tsonubin/ps5-slim-stand/docs/CONTINUE.md

# Continue the PS5 Slim dock

## Latest request
Continue the existing Claude PS5 Slim vertical-stand design in a new project using Astra.

The exact final user message in Claude was:

> I think you are too truthful to my drawings, but you nailed the vibe.  The only think I want you to optimize is that I want to have better curve, more continuous, natural curve. And please optimize for 3D printing. The bottom is not very pretty, also please take consideration of it, and also the aerodynamic of the bottom intake of PS5 slim (Actually I'm not sure if it is intake or outtake)

Claude stopped without answering because its usage credits were exhausted. Do not restart Claude or purchase credits.

## Design intent and evolution
The user wants to elevate a vertical PS5 Slim, preserve its sleek curves, improve ventilation, and resist tipping. Blue or white printing was explicitly requested. The most recent model is for the **Disc** version, as indicated by the sketch and Claude's response.

Earlier bulky spider-web and flat truss versions were rejected. The user wanted cool bridge architecture, minimal triangular structure, physics checks, more curves, body-following supports, asymmetry and compactness. The user supplied the Sketchfab reference and later the actual model archive, which revealed earlier straight-sided fit assumptions were wrong. Do not revive v3 or treat its dimensions/simulation figures as reliable.

The preferred latest direction is one piece with a flowing exterior, hidden structural complexity, a sculptural saddle rim and lattice skin inspired by Zaha Hadid. The user said “Bella Hadid's architecture”; Claude interpreted this as Zaha Hadid, and the subsequent feedback accepted the vibe. The sketch is guidance, not a literal shape to reproduce.

A looser fit was explicitly requested. v4/v5 used 1.5 mm clearance all around. Retain appropriate tolerance and provide a low-cost fit gauge before the full print. The fan-made reference is not a verified scan of the user's actual hardware.

## Latest v5, as reported by Claude (not independently verified)
- One body, smooth inner wall, diamond lattice outer skin, zig-zag buttress ribs between them.
- Under-console triangulated rib web with pointed arches and diamond windows.
- Footprint 154 × 244 mm, maximum height 72 mm, approximately 200 g PLA.
- Saddle rim: 46 mm middle, 72 mm rear corners, 60 mm front corners, 38–40 mm front/back walls.
- Lattice 68 × 3 cells; 2 mm struts; generated in 0.5 mm steps, producing visible terracing.
- Claude claimed 46° or steeper opening roofs and 47° minimum strut slope, upright printing without support. **It was never sliced or printed.**
- Claimed tipping force 6.0–6.9 N and rough strength margin 5–12×. These were simplified estimates; no lattice stress simulation was run.
- Rear wall reportedly 10 mm above the console base, rear power socket clearance unverified.
- Front rim reportedly up to 20 mm above console base; disc-slot start guessed at 26 mm from a screenshot.
- Console load should be supported on the black core, not suspended from white covers.

## Inputs already present
- `references/PS5_Slim-a48efc06.zip`: user-supplied archive already in Downloads, copied without alteration.
- `references/console-model/PS5_Slim.glb` and accompanying glTF/bin files: extracted from the same archive.
- `references/IMG_6973.HEIC`: original sketch already in Downloads, copied without alteration.
- `docs/claude-conversation.md`: recovered visible conversation text. The first prompt is visibly truncated, and table formatting is flattened. Treat earlier assistant claims as historical evidence, not verified design facts.
- Model source: https://sketchfab.com/3d-models/ps5-slim-a48efc06663541a1bc19297995fea91d, author rtql8d.
- Chat: https://claude.ai/chat/f4d270b2-2594-4b75-a828-277e58a32ab0

## v5 source import completed
The user supplied all four files directly. Originals are preserved in `references/user-imports/`; their Library identities, versions and SHA-256 hashes are recorded in `docs/import-manifest.json`.

The complete source ZIP is extracted at `designs/imported/ps5_veil_stand_v5/`:
- `source/ps5_veil_stand.py` (main generator)
- `source/checks.py`, `source/splat.py`, `source/preview.py`, `source/outline.json`
- `ps5_slim_disc_veil_stand.3mf` and `ps5_slim_disc_veil_stand.stl`
- `GAUGE_cavity_outline_1.6mm.stl`, `preview.png`, `checks.txt`

ZIP integrity passed. The separately uploaded 3MF is byte-identical to the one in the ZIP. The uploaded console ZIP matches the earlier local copy. The separately uploaded preview is different bytes from the ZIP's preview; keep both, and use `references/user-imports/preview.png` as the explicit uploaded visual reference. It has been visually inspected and shows the flowing saddle, flared diamond-lattice shell and angular radial bottom web in white and blue.

The earlier browser download is no longer needed. Do not retry it or any denied Codex UI operation.

Source was read but **not executed**. It uses numpy, manifold3d, scipy, trimesh and Pillow. The generator writes an `out/` directory including V.npy, F.npy, footprint.npy and console_ghost.stl; these intermediate files are not in the ZIP and must be regenerated for preview/check scripts. `preview.py` has a Linux DejaVu font path that will need a portable replacement on macOS. Preserve imported originals and work in a new version directory.

The generator uses a 30 mm console lift, default DZ=0.5 mm, 1.5 mm clearance, 1.8 mm skin, 1.2 mm ribs, 2 mm lattice struts, and stacked extruded cross-sections. Its claim of support-free printability is not validated by a slicer. The checks are rigid-body tipping and wall-bending hand calculations, not FEA or airflow simulation.

## Next work
1. Inspect the actual sketch pixels, reference mesh and v5 preview/source. Preserve the original imports.
2. Verify PS5 Slim airflow path and bottom vents using reliable Sony documentation or a reputable teardown. The user is unsure whether the bottom region is intake or exhaust. Do not invent an aerodynamic claim or imply a CFD simulation was run.
3. Develop a v6 that keeps v5's flowing, one-piece character but uses continuous natural curvature instead of coarse terracing or an overly literal sketch outline. Improve the visible underside/base and maintain clear airflow.
4. Check load path, tipping resistance, ports/disc clearance, support-free geometry where realistic, minimum features and actual slicer behavior. Distinguish simulation, conservative estimate, geometry check and physical validation.
5. Provide editable source, STL/3MF, small fit gauge, blue/white rendered views, practical print guidance and clear unverified dimensions. Ask only for hardware/printer information that materially blocks correct design.

Check relevant local `.agents/skills` if required capabilities are missing. Do not change unrelated projects, publish, buy, or fabricate print/engineering validation.

## v6 continuation completed — 2026-11-11

See `designs/v6/README.md`, `VALIDATION.md` and `PRINT_SERVICE.md`. The user added PlayStation triangle/circle/X/square motifs and confirmed a Taobao/Alibaba print service rather than a known personal printer. v6 uses continuous lofts, an oval core ribbon, swept cross-ribs and shaped apertures. STL/3MF, a new gauge, a small print-test section, actual mesh renders and geometric layer screening are present. All original uploads and imported v5 files were checked unchanged. No production slicing, physical fit, strength or thermal validation is claimed; the exact bottom vent direction remains unresolved. Next step is vendor slice review and gauge/test-section printing, then hardware contact/clearance and dummy-load validation. Do not mistake `layer_screen.json` for toolpaths or the reference assembly rendering for confirmed fit.

## User clarifications and v7/v8 continuation — 2026-11-11

The user explicitly clarified that the exterior should remain a mesh, with smoother macro-scale curves, irregular asymmetry and a **bird nest** analogy. Triangle, circle, X and square mean the **cross-section of each actual strand**—like the cut end of shaped steel wire—not the cell opening, projected strand path or rib holes. For the underside, prioritize structure; the user prefers star-like or honeycomb structures, with symbols used selectively. Star-like ribs are the current candidate, not a claim of universal superiority over honeycomb.

The user will use a Taobao/Alibaba print service, so no personal printer has been specified. Practical printing optimization remains required; vendor slicing, test coupons and physical fit/load/thermal checks are outstanding.

The user requested real **3D stress heatmaps** and iteration from physical simulation. v7 now has solid linear-elastic finite-element calculations, an interactive stress/displacement viewer and actual field renders; see `designs/v7/STRUCTURAL_ANALYSIS.md`. Stress colors are not temperatures. Material and support/contact assumptions, geometry regularization and mesh sensitivity prevent any claim of "no weak point." A smooth local strand collar is the simulation-driven trial retained in v7; unreinforced geometry is preserved in `designs/v7/baseline/`. A rounded-toe trial and compact honeycomb comparison were exploratory and do not establish a winning topology.

The user then clarified concern about **physical desk footprint**, not storage size. Wider reinforced v7 is 161.65 × 251.76 × 65.22 mm. Compact v8 has been generated at 151.02 × 244.23 × 65.22 mm by pulling the outer flare inward, preserving the cavity, nominal clearance, 30 mm seat and rim landmarks. v8 reduces projected convex-hull area by about 8.8%; its geometry validation is present, and its separate stress analysis is underway. Do not transfer v7 strength conclusions to v8. v8's geometric layer screen flags 42 nonoverlapping-island events versus 21 in v7, so compactness has not established support-free or easier FDM manufacture.

The user explicitly requested keeping the main discussion in the parent thread and delegating modifications/testing to sub-agents. CAD and FE tasks are delegated accordingly. The user also requested local and remote updates and PR recreation as needed; after being told the project lacked a Git remote, they explicitly authorized creating a repository under **tsonubin**. Private `tsonubin/ps5-slim-stand` now exists; see the current Git/PR state for upload status.

Original-file verification was repeated: all four uploads and all ten imported v5 files remain byte-identical, including the original fit gauge (`docs/originals_check_v7.json`). Preserve v6 and v7 when working on compact v8.

### Latest aesthetic feedback

After the footprint discussion, the user rejected the v7/v8 appearance and asked the designer to choose a stronger visual direction. v9 is now being developed with fewer, longer sweeping strands, a quieter rim and a low asymmetric nest silhouette. Treat v7/v8 as preserved engineering/design history, not an approved final design. Keep their validation tied to their own geometry; the new design requires fresh checks.

## Latest controlling direction — v10 after v9 rejection

The user explicitly rejected v9. Do not describe it as selected or approved. The latest exterior direction is a **dense web with a Spider-Man / bird-nest character**, visually continuing the console's bottom rather than reading as a separate sparse basket. Use **unified rounded strand cross-sections**: the user has withdrawn the earlier requirement for PlayStation-symbol cross-sections in the exterior wires. Do not preserve that superseded requirement in new CAD or briefs.

For the underside, the user asked for PlayStation button shapes or something sleeker. The chosen development direction is **quiet curved supporting structure, without the exposed star pattern**. Do not claim the user approved a new final underside before reviewing it. Compact desk footprint and real printing feasibility remain active constraints.

v10 is in progress; wait for geometry review before writing a final v10 production brief or declaring it selected. v7, v8 and v9 remain historical. v8 FE preparation reached a mesh only, with no solved v8 stress result. v9 structural analysis was cancelled after the rejection. v7's actual solved fields remain valid only for its own approximate geometry and assumptions; none establish the strength of v10.

## v10 geometry ready for aesthetic review

v10 has been generated and its actual mesh/assembly previews reviewed internally. It is **not yet user-approved**. See `designs/v10/README.md`, `output/preview_v10.png` and `output/reference_assembly.png`. The model is 151.32 × 244.47 × 53.22 mm, 131.40 cm³, with two long contour strands and 66 rising strands using a unified 3.3 mm round section. Three curved rails and two transverse ties replace the star hub. Current defaults: `VEIL_SUPPORT=sleek`, `VEIL_REINFORCE=0`.

The main mesh is one connected watertight body. Reference-plan intersection is 0 mm³; nominal-clearance-envelope intersection is 0.5073 mm³, so nominal clearance is not an exact everywhere minimum. Reference black-core overlap is about 1,055 mm², not measured physical contact. The geometric layer screen flags two nonoverlapping-island events and a major overhang region near the smooth arches (191.65 mm² outside the 45° growth envelope at z=14.1 mm). Provider slicing, supports/removal and material review are required; printability is not qualified.

**No FEA has been run for v10.** Do not relabel v7 heatmaps as v10 results or imply prior reinforcement carries over. The next design decision is user aesthetic review; if accepted, perform fresh structural screening and process validation on this geometry. The v10 bilingual vendor brief is a prototype/process-review brief, not a production approval.

The final v10 local print coupon is 58 × 36 × 48.138 mm, 9.73879 cm³. Its crop (X=22–80 mm, Y=34–70 mm) includes a transverse tie/outer-web connection; the earlier small crop was replaced. The main CAD is unchanged.

## Current v11 candidate — continuous guides and clean connections

The user's latest request is a smoother continuous exterior, mathematically guided mesh and dedicated clean connections to the upper and lower rings. v11 is generated and independently geometry-checked; it remains a development candidate, not a user-approved or qualified production part. v10 is preserved.

The actual construction uses periodic cubic radius/height guides, a quintic strand-height law, rounded rings and local additive distance-field blends: 132 ring-root patches at 0.20 mm pitch and 305 selected middle-web crossing patches at 0.12 mm pitch. Midspan strands remain round, nominal diameter 3.3 mm; three curved rails and two ties remain underneath. Local smoothed clearance corrections retain the compact base envelope. C2 scalar guides and designed centerline tangency do not prove exact G1/G2 continuity of the triangulated Boolean surface. Flat-shaded comparisons show small remaining patch-boundary bands; no global surface-continuity claim is made.

Final dimensions: **151.714 × 244.556 × 53.218 mm**, geometric volume **128.409 cm³**, 2,205,760 triangles. STL/3MF reopen as one watertight consistently wound body and agree in dimensions/volume. Reference-plan intersection is 0 mm³; nominal-clearance-envelope intersection is 1.263e−5 mm³ at numerical/export scale. The local coupon is 58 × 36 × 48.170 mm, 9.473 cm³ and includes a tie/web region. Full-body export used independently checked sub-resolution sliver welding (11 edge pairs, maximum movement 8.148e−6 mm, 15 collapsed faces removed, volume change 1.342e−7 mm³), then 0.004 mm simplification; no generic hole filling was used.

The geometric layer screen still flags significant arch overhang (184.65 mm² outside the preceding 45° growth envelope at z=14.1 mm) and two new nonoverlapping-island events. Actual slicing/support removal is required. **No FEA has been run for v11**; v7 heatmaps are historical, not validation of this model. Hardware fit, core contact, ports/vents, physical loads, creep and thermal behavior remain unverified.

Read `designs/v11/README.md`, `GEOMETRY_METHOD.md`, `PRINT_SERVICE.md`, and final validation/independent-review JSON. Clean previews and flat-shaded comparisons are in its output directory. Git carries the 3MF and losslessly compressed `.stl.gz`; the raw STL is approximately 110 MB and remains local. Decompress before validation/rendering from a fresh checkout. Large preblend/root-only/guide caches are regenerated by source and excluded from Git. Reproduction is `veil_v11.py` then `blend_crossings.py`, followed by validation/rendering; the delivered build's repaired-cache recovery provenance is documented in the method.

## Latest controlling direction — v12 aesthetic redesign

The user rejected v11's appearance despite its smoother geometry. They explicitly approved a **continuous sculpted surface with dense flowing openings, a restrained silhouette and concealed supports**. The new direction is a perforated surface, not a collection of visibly intersecting pipes; it should be judged as a whole object rather than by smooth junctions alone.

v12 is currently being built from a nominal 2.8 mm shell with flowing cutouts, integrated edges and a lower branching internal web. This describes implementation in progress, not accepted final dimensions or proven printability. Do not call it premium, approved or successful before reviewing the actual rendered geometry with the user. Preserve v11 as historical work; its curve/patch validation does not establish that it met the aesthetic goal or validate v12.

The immediate priority is **visual review of the actual v12 candidate**. Hold full v12 documentation and further engineering work until that candidate is reviewed. Avoid presenting an engineering checklist as a substitute for addressing the appearance. Existing compact-footprint, console-clearance and outsourced-printing constraints remain relevant; no physical qualification has been claimed.

v11 source-reproduction note: the standard two-stage build now includes bounded repair and automatic fine-cache recovery where required. That integration was syntax-checked/audited but was not rerun end to end; the actual delivered v11 used the independently reviewed repaired-cache recovery path. Its gzip roundtrip and manufacturing hashes were verified (`designs/v11/output/deliverable_hashes.json`).

## Current v12 visual candidate — final adaptive rounding

The continuous perforated-shell direction has now been built as the next **visual prototype pending user review**, not a premium/final/qualified product. It uses a nominal 2.8 mm shell with 72 irregular rounded Voronoi-derived openings, a shared periodic flow warp, integrated upper/lower edges and a lower bowed/branching internal web. There are no independent exterior tubes or horizontal aperture rows. The final local refinement increased opening corner rounding while retaining the selected cell layout, silhouette and supports; actual chart radii span 2.2–3.0 mm.

Frozen final geometry: **150.395 × 240.625 × 48.042 mm**, **76.708578 cm³**, **166,726 triangles**. STL/3MF agree and are one connected watertight consistently wound body. The inherited cavity is unchanged, seat height is 30 mm, and final console-plan and cavity-envelope intersections are both 0 mm³. A mapped maximum-bevel polygon-boundary screen gives a minimum sampled gap of 2.89360 mm; this is not a complete finished-wall-thickness or printability certification. The final coupon is 58 × 36 × 45.500 mm, 7.23784 cm³ and includes actual support geometry. Do not reuse the earlier 73.49 cm³ intermediate figure.

See `designs/v12/README.md`, `GEOMETRY_METHOD.md`, `PRINT_SERVICE.md`, the actual `output/hero_v12.png` and `assembly_base_detail.png`, plus `analysis/light_geometry_review.json` and `aperture_spacing_preflight.json`. The priority remains user review of the appearance. **No FEA or production slicing has been run for v12**, and no physical fit/load/thermal qualification is claimed. Historical v7 stress results are not evidence of v12 strength; earlier designs remain preserved exploration.

## Latest controlling request — v13 perimeter refinement and engineering

The user **likes v12's current shell design** and specifically likes the lower loop. Preserve this direction. They request more even-height upper/lower loops with continuous spatial curvature, checks that the lower passage does not impair PS5 airflow, fresh stress analysis, and airflow simulation with the bottom sealed. They suggest using modeling to locate the lower intake. Do not infer real active vents from the supplied fan-made exterior mesh.

v13 keeps the 72-cell continuous shell, cavity, 30 mm seat and curved support scheme. Finite Fourier perimeter guides replace local ripples; upper height is 38.030–40.700 mm versus v12's 33.954–48.042 mm, while the lower ring remains planar. Maximum lower-plan movement is 1.619 mm. The analytic guides are C∞; this does not certify the complete tessellated/Boolean shell as G2.

Frozen CAD: **150.339 × 241.277 × 40.700 mm**, **74.605282 cm³**, **170,792 triangles**; STL SHA256 `bea7633ae9056bdd5e5f3f4c0e4ced1c9958bf9ea5c77ac0db26fd036f9fed11`. STL/3MF agree; one watertight body, consistent winding; unchanged cavity and zero reference/cavity interference. The mapped maximum-bevel aperture screen gives 3.04264 mm minimum sampled separation, not a finished-wall certificate. Gauge is byte-identical to v12. Coupon is 58 × 36 × 40.700 mm, 6.93403 cm³. All 14 original import entries were rechecked (`designs/v13/analysis/originals_check.json`).

Fresh v13 FEA and conditional airflow calculations have been solved; their final reports and deliverables are linked in the v13 README. They are exploratory, not qualified. The user confirmed CFI-20xx hardware and the sealed-bottom condition: an impermeable solid desktop at z=0 with side apertures open. Actual bottom vent geometry remains unresolved. Numerical hypothetical ports cannot prove real thermal safety. See `designs/v13/README.md` for final links and status.

v13 engineering outcome: three vertical-load meshes give maximum displacement 0.149–0.157 mm but moving/unconverged peaks 21.61–51.25 MPa. Do not label strength passed, choose only the favorable peak, or claim all weak points are eliminated. FEA uses simulation-only regularization (−0.949% volume; sampled P95 surface distance 0.198 mm, max 0.894 mm), assumed E1200 MPa/ν0.35, 31.392 N applied seat pressure and fully fixed lowest nodes. Local 10 N side-push cases are not console-top tipping/contact analyses. Internal junction and contact refinement remain actionable; production CAD has not been altered to chase unstable numerical peaks.

Conditional airflow uses a capped 30 mm high surrogate channel, impermeable desk and arbitrary roof port, with actual stand geometry below 30 mm. Central-port conductance falls 20.9–25.4% across 3/2/1.5 mm grids relative to an empty channel; an offset hypothetical port is more restricted. This is not real PS5 flow-loss prediction or thermal CFD, and spatial convergence is not established. iFixit Slim imagery shows a lower rear grille. The rim sits 8.03–10.70 mm above the seat, so real grille spacing/overlap must be checked; neither the reference GLB nor this surrogate can clear actual ventilation. Preserve the accepted exterior while resolving internal load paths and actual vent geometry. Do not release as service-use-ready.

## Git version markers

User requested explicit version-control markers. Annotated tags `v5`–`v13` are documented in `docs/VERSION_HISTORY.md`; early batched/imported snapshots are explicitly distinguished from dedicated version commits. For future numbered designs, commit and tag each milestone separately and push both branch and tag. Never silently move published version tags.

## v14 — convex wall, seat pads, blended rib feet, CalculiX and OpenFOAM studies (2026-11-12)

v14 keeps v13's shell and opening pattern and is now the main version; read `designs/v14/README.md` first and `designs/v14/PRINT_SERVICE.md` for the print plan. The mid-task handoff list was worked through on 2026-11-12 and the handoff file removed; what is still open is listed in the README's "Still open" section.

Frozen CAD: **152.83 × 247.08 × 40.70 mm**, **79.26 cm³**, STL SHA256 `f1d0bfc22a9153e16242919a86aeb8b0463d0420215a4993fba140493aacfccf`. One watertight body; zero intersection with the reference plan and cavity.

What changed against the first v14 build (78.54 cm³): every rib end is blended into the wall (3 mm rolling-ball fillet inside the wall face, 1.5 mm inside the wall thickness). The unconverged stress peak that the handoff attributed to a rib foot "near the floor" was one cross-rib end crossing a wall opening and touching its lower rim at a single point. After the blend that peak is gone and the weight-case peak holds at 4.6–4.9 MPa on three meshes. From outside, that one opening now shows a small rounded pocket. **The user has not yet seen or approved this visible change.**

Decisions already made by the user: final part in white, bead-blasted SLS PA12 from the UnionTech service; first a PETG fit check of the gauge and coupon on the Bambu H2D; MJF only if black is wanted.

Do not claim: a cooling prediction (all OpenFOAM flow rates are assumptions; real vent map, fan flow and rear-grille clearance are unmeasured), a converged contact peak (it rises with refinement at the pad edge), or anything about creep and warm-air softening (not estimated). Nothing has been printed.

The user asked for v14 to be tagged and its print files published as a GitHub release (tag `v14`).

## Only v14 kept (2026-11-12)

At the user's request the design folders for v5–v13 (`designs/imported`, `designs/v6` … `designs/v13`) were removed from the branch; tags v5–v13 were kept, so each version is still available at its tag. This supersedes the earlier instruction to preserve prior designs in the tree. Paths to those folders elsewhere in this file are historical. The few v13 files that v14's review scripts compare against now live in `designs/v14/baseline_v13/`. The top-level README was rewritten around v14 alone (specifications, design philosophy, stress test, airflow test, printing notes). The original uploads in `references/` were not touched.
