tsonubin/ps5-slim-stand/docs/claude-conversation.md

# Recovered Claude design conversation

Source: https://claude.ai/chat/f4d270b2-2594-4b75-a828-277e58a32ab0
Title: PS5 Slim vertical stand design
Read on 2026-11-11. This is text recovered from the displayed conversation. Original design claims below are not independently validated. The first prompt appears truncated in the displayed source.

## Message 1: User

Can you help me design a 3D model to elevate my PS5 Slim while it stands vertically? I checked the options online and I found them either lacks of the charm of the sleek PS5 design, or it doesn't really help ventilation. My idea is to have a sleek and also fluent design of architecture to both successfully levitate the PS5, meanwhile providing support so that the PS5 doesn't easily flip over. And since it's going to be a like spider net like structure, it doesn't block the flow of the air, and it designed t

## Message 2: Claude

I’ll confirm the PS5 Slim’s exact dimensions, then build a printable model with preview renders.

I’ve designed the stand, which I’m calling the “Web Stand”: a spider-web frame that lifts the console 20 mm off the desk, with two arched side walls that hold it. Both versions are complete solid models, but I haven’t printed one, so print the fit-test strip first.

How the design works

Spider web:  under the console, spokes run out from a centre ring and are crossed by rings, like a real web. The parts of the web that touch the desk curve down to it in pointed arches, so the stand only touches the desk at the points where the strands meet. That gives the “floating” look and lets air pass under the console.

Stability:  two web “wings” spread out to the sides and slope down to the desk. The PS5 tips over sideways most easily, because it’s only 80 mm thick. The wings make the base about 172 mm wide, roughly twice the console’s thickness, so it should be about twice as hard to tip.

Grip:  the two side walls rise to 34 mm in the middle and taper to nothing at the front and back. They have a pattern of diamond-shaped holes.

Airflow:  the front and back are left completely open, so nothing covers the vents on those faces.

Which file to print

Sony lists the Slim at 358 x 96 x 216 mm for the regular model and 358 x 80 x 216 mm for the Digital Edition model, so there are two STL files:

Digital Edition:  the “digital” file.

Disc Edition:  the “disc” file. The 96 mm figure includes the bulge of the disc drive. Measure how thick your console actually is across the bottom 35 mm, where it sits in the stand. If it’s closer to 80 mm, use the digital file.

Printing

Size:  about 172 × 227 × 54 mm. It needs a print bed at least 230 mm long on one side. A 256 mm bed works, and on a Prusa MK4 you’d turn it 90°.

Material:  about 280–300 g of PLA or PETG, with 4 walls and 20% infill.

Supports:  none needed. Every arch and diamond hole was drawn at 45° or steeper.

Fit test:  the zip has “FIT_TEST” files. Each is a 20 mm-wide slice across the middle of the stand, about 35 g, that prints as two small pieces. Print one and press the pieces against the bottom edge of your console before committing to the full 280 g print. The stand allows 1 mm of space on each side of the console. If it’s too loose, stick on thin felt or TPU pads.

The zip also has 3MF files, which open more cleanly in Bambu Studio and PrusaSlicer. It also includes the Python script that generates the model, in case you want to change the height, wing size or wall height.

## Message 3: User

Not slim and cool enough as I expected. I was thinking like some kind of cool bridge architecture. With minimum triangle architecture to remain stable. You can use physics simulation to test stability and strength.

## Message 5: User

And I think for the surface you can include more curve, just like PS5.

## Message 7: User

We will print it in either blue or white.

## Message 8: Claude

Scrapping the web. I’m redesigning it as a slim bowstring-arch bridge kit with PS5-style flared legs, and I’ll run stress and tipping simulations on it.

I’ve replaced the web with a bowstring-arch bridge: two slim arch trusses that run along the console’s sides, carried on two flared legs. The simulations say it holds the console with a wide safety margin and takes about 1.7× the sideways push to tip, but I haven’t printed it.

The design

Two arch trusses:  each is a curved arch over a straight bottom beam, joined by four diagonals in a W, so five openings in all. The console sits between them and the arches hold its sides.

Two piers:  cross-pieces under the console with legs that sweep outward in a concave curve, echoing the PS5’s flared plates. Each has one triangular opening per side.

Floating look:  the stand touches the desk at four small feet only, and the console overhangs the piers by 54 mm front and back.

Size:  150 mm wide, 222 mm long and 62 mm tall for the Digital version (the Disc version is 166 mm wide). The console sits 30 mm above the desk.

It’s now a 4-piece kit.

Smooth arches like these can’t be printed upright without supports, so each piece prints lying flat and they slot together. The outward-facing edges are rounded. The slots are 0.2 mm wider than the piece that goes into them; add a drop of superglue if they feel loose.

What the simulation showed

(designed for the heavier 3.2 kg Disc console, PLA):

Test

Result

Push at the top needed to tip it sideways

6.1 N, against 3.5 N for the bare console

Lean angle before it falls

19.7°, against 12.6°

Energy needed to topple it

3× the bare console

Console resting on the piers

3.5 MPa peak stress, 11× safety margin

Sideways knock hard enough to tip it

about 4× safety margin on both piers and trusses

The same knock, doubled for a sharp bump

about 2× safety margin

The first version of this design failed my own targets on the sideways knock, so I thickened the trusses to 7 mm, moved the piers inward and rounded the slot corner where stress peaked. The strength figures come from 2D stress analysis of each flat piece, plus a simple beam-frame model for the truss bending sideways — an approximation, not a full 3D solid simulation. I assumed a conservative PLA strength of 40 MPa.

Printing

Parts:  print the truss twice and the pier twice. Use the “digital” files for an 80 mm console and “disc” for 96 mm; as before, measure the bottom of your console first.

Material:  about 100 g in total, no supports. Use 4 walls so the slim members print nearly solid.

Bed:  the truss is 222 mm long, so it needs a bed at least 225 mm on one side.

Colour:  white matches the console’s plates and shows the curves best. Blue makes the stand read as a separate bridge object under the console.

Nothing stops the console sliding front to back except friction; two thin rubber dots on the pier tops would fix that.

## Message 9: User

How do you think you can improve this? I think you can shape the side support better by fits it with the body curve of PS5, and in-order to introduce more asymmetry and compact design.

## Message 10: Claude

Yes, both of your ideas point at the real weak spots in this version: the side supports are flat plates against a curved console, and the symmetry makes it read as a generic bridge instead of something made for the PS5.

Contoured saddle instead of flat sides.  The inner faces of the trusses would follow the console’s curved plates, so it sits in a cradle and not against two straight edges. This also stops the front-to-back sliding I flagged last time, because a curve locks the console in place where a flat face can’t.

Asymmetry with a reason behind it.  I’d move the arch crown toward the back, like a single-pylon bridge: tall at the rear where the cables are, tapering to a low thin tip at the front. On the Disc model, the drive bulge sits on one side only, so the two trusses would differ as well.

More compact.  The trusses run the full 222 mm now, but the console overhangs the piers anyway, so I can cut the length to roughly 150 mm and lower the arch. The one thing I wouldn’t shrink is the foot spread: the 150 mm width is what gives the 1.7× tipping resistance, and every millimetre taken off costs stability directly.

Fewer pieces.  A shorter stand fits more print beds, so it could go from four slotted parts to two, or possibly one, which removes the loose-joint risk.

I’d rerun the same tipping and stress tests on the new shape, since an off-centre arch loads the two piers unequally. The catch is that I only have Sony’s outer box dimensions, not the actual curve of the plates. If I guess it, the saddle won’t fit. Can you tell me whether yours is the Digital or Disc model, and send a photo taken straight down at the console’s bottom end with a ruler in frame? If that’s a hassle, I can instead print-test it: a thin 5 g gauge strip you hold against the console, and adjust from there.

## Message 11: User

You can use this as reference:

## Message 12: Claude

Browser

Version 3 is built from that reference: shorter, asymmetric, and sized to the console’s actual footprint instead of a plain box. The body measurements are my estimates from screenshots of the Sketchfab model, so the fit is unproven until you print the gauges.

What I took from the reference

Viewer only:  the page showed no download, so I rotated the model in the viewer and scaled what I saw to Sony’s 80 / 96 mm widths. Expect a few millimetres of error.

Front taper:  the body narrows toward the front, by about 2 mm between the two piers.

Disc bulge:  on the Disc model the drive bulge sits on one side and toward the front, so that side is about 16 mm wider and narrows toward the back.

What changed

Fitted sides:  each truss is angled 1–2° to follow the taper on its side, and the front and rear piers have different seat widths. On the Disc model the whole stand is offset to one side, as the bulge dictates.

Asymmetric arch:  the crown now sits toward the back, with a long low sweep to a thin tip at the front and a steep drop behind.

More compact:  length is 156 mm, down from 222 mm, and it uses about 82 g of PLA (85 g for Disc), down from about 100 g. Width is 153 mm (168 mm for Disc), because the foot spread is what resists tipping.

Unequal horns:  the off-centre crown puts about 3.5× more load on the rear pier’s horns than the front’s (33 N against 9 N). I made the rear horns thicker and the front ones slimmer.

Simulation results

(3.2 kg console, PLA)

Test

Digital

Disc

Push at the top needed to tip it

5.9 N, against 3.4 N bare

6.2 N, against 3.8 N bare (weaker direction)

Energy to topple it

2.9× bare

2.3–2.7× bare

Console resting

13× safety margin

11×

Weakest part under a tipping-force knock

3.4× (rear pier)

3.4× (rear pier)

The same knock, doubled for a sharp bump

1.7×

1.7×

The sideways-knock margin is a little lower than version 2’s (about 4× and 2×); that is the cost of the off-centre crown. For the Disc model I assumed the centre of gravity sits slightly toward the drive side.

Printing

Four different parts now:  left truss, right truss, front pier, rear pier — one of each, flat, no supports, 4 walls.

Gauges first:  the zip has a 2 mm-thick copy of each pier. Print both and hold them under the console at 58 mm from the front and 58 mm from the back; the console should drop between the slots with about 1 mm to spare each side.

If the gauges are off:  tell me by how much and I’ll regenerate; the body widths are five numbers at the top of the script.

Nothing stops the console sliding front to back yet except friction. Sources:

## Message 13: User

This is the model. From the top down angle, I didn't see any curve. Is the PS5 design like this?

## Message 14: Claude

No, the PS5 isn’t straight like that: your model shows a strongly curved base, and my v3 stand misses it. I misjudged the shape from the viewer screenshots, so don’t print v3. Measured from your file (which is at real scale, 358 × 216 mm), looking down at the lowest 30 mm of the console:

Distance from the back

Plain side, from centre

Disc side, from centre

5 mm

40 mm

39 mm

58 mm (rear pier)

38 mm

46 mm

108 mm (middle)

34 mm

50 mm

158 mm (front pier)

26 mm

53 mm

205 mm

14 mm

27 mm

Plain side:  it sweeps inward in a continuous curve, from 40 mm at the back to about 12 mm at the front tip. I had assumed a 2 mm taper; the real figure is closer to 28 mm.

Disc side:  the drive cover bows outward to about 54 mm, then cuts in sharply over the last 20 mm at the front.

Fit of v3:  at the front pier the plain-side truss would stand 12 mm away from the console, and the disc-side truss 7 mm away at the rear pier. On the Digital model both sides would have the 12 mm gap.

Base:  the console doesn’t rest on the white plates. It stands on the black core, a boat-shaped foot about 63 mm wide and 134 mm long, and the plates hang 4.5 mm above it.

This is a fan-made model, so I can’t confirm it matches the real console to the millimetre. You can check by looking down at the base of yours: the white plates should visibly close in toward the front. Flat, straight trusses can’t follow a curve like this. For v4 I’d replace them with two rails curved in plan to the measured outline, sitting on the piers, with the fin arch rising from each rail. The stand would then be boat-shaped from above, narrow at the front like the console, and the curve itself would stop the console sliding forward. I’d rerun the tipping and stress tests, since a narrower front changes both. Shall I build v4 that way, and is yours the Disc or the Digital model?

## Message 19: User

I think this is too solid, lacks of some high skilled, Maximalism. I think Hadid's architecture's beauty is to hide the complexity inside fluent surface.  I think we need to rethink about this as one piece. I don't know if this can better understand my intention.

## Message 20: Claude

Created

ps5_veil_stand.py

Checking the skin's slope and the rim's angle against the roof target.

Your sketch made it clear, and version 5 is rebuilt around it: one piece, with a rim that sags in the middle and rises at the four corners, and the structure hidden behind a flowing lattice skin. It’s for the Disc model, as your sketch says. It hasn’t been sliced or printed, and it’s a demanding print.

How I read the sketch

One body:  the console drops into a cavity cut to its measured outline, with the same 1.5 mm gap all round.

Saddle rim:  from the side, the top edge dips to 46 mm in the middle and rises to 72 mm at the rear corners and 60 mm at the front corners. The front and rear walls stay low (38–40 mm).

Lattice skin:  the outer surface flares smoothly to a wider base and is a diamond lattice of 68 × 3 cells. The cells scale with the rim height, so they are about 14 mm wide at the peaks and 7 mm at the low ends.

Hidden complexity:  behind the skin is a row of zig-zag buttress ribs and a smooth inner wall facing the console. Under the console, a triangulated web of ribs with pointed arches and diamond windows carries the weight and lets air pass.

Checks

Tipping:  it takes a 6.0–6.9 N push at the top to tip it sideways, against 2.0–2.8 N with no stand and 6.1–6.9 N for Sony’s ring stand as modelled in your file.

Strength:  the double wall has a safety margin of about 5–12× under a knock hard enough to tip it. That is a hand calculation; I did not run a stress simulation on the lattice.

Fit:  the model shows no overlap with the console outline from your file.

Printing

Size and weight:  154 × 244 × 72 mm and about 200 g of PLA, so it needs a bed at least 250 mm long.

Orientation:  upright as exported, no supports. Lattice openings have roofs of 46° or steeper, and the most-leaning strut is 47° from horizontal. That is near the limit, so print slowly with strong cooling.

Struts:  they are only 2 mm wide; with a 0.4 mm nozzle that works, but a failed strut will show.

Surface:  the model is built in 0.5 mm steps, so the flared skin has fine terracing.

Gauge first:  the zip has a thin outline of the cavity. Stand the console in it before a 200 g print.

Things I couldn’t verify

Rear ports:  the rear wall sits 10 mm above the console’s base. If the power socket is lower than that on yours, the wall needs a notch.

Disc slot:  the front rim is at most 20 mm above the base, and I estimated the slot starts at about 26 mm from a screenshot of the model.

The web under the console is the plainest part, and it’s hidden once the console is in. If you want the maximalism to show more, the next step would be a second lattice layer or larger peaks; tell me which direction feels closer.

## Message 21: User

I think you are too truthful to my drawings, but you nailed the vibe.  The only think I want you to optimize is that I want to have better curve, more continuous, natural curve. And please optimize for 3D printing. The bottom is not very pretty, also please take consideration of it, and also the aerodynamic of the bottom intake of PS5 slim (Actually I'm not sure if it is intake or outtake)
