tsonubin/ps5-slim-stand/designs/v14/output/ccx_coarse_contact_eccentric_1g_stress.png

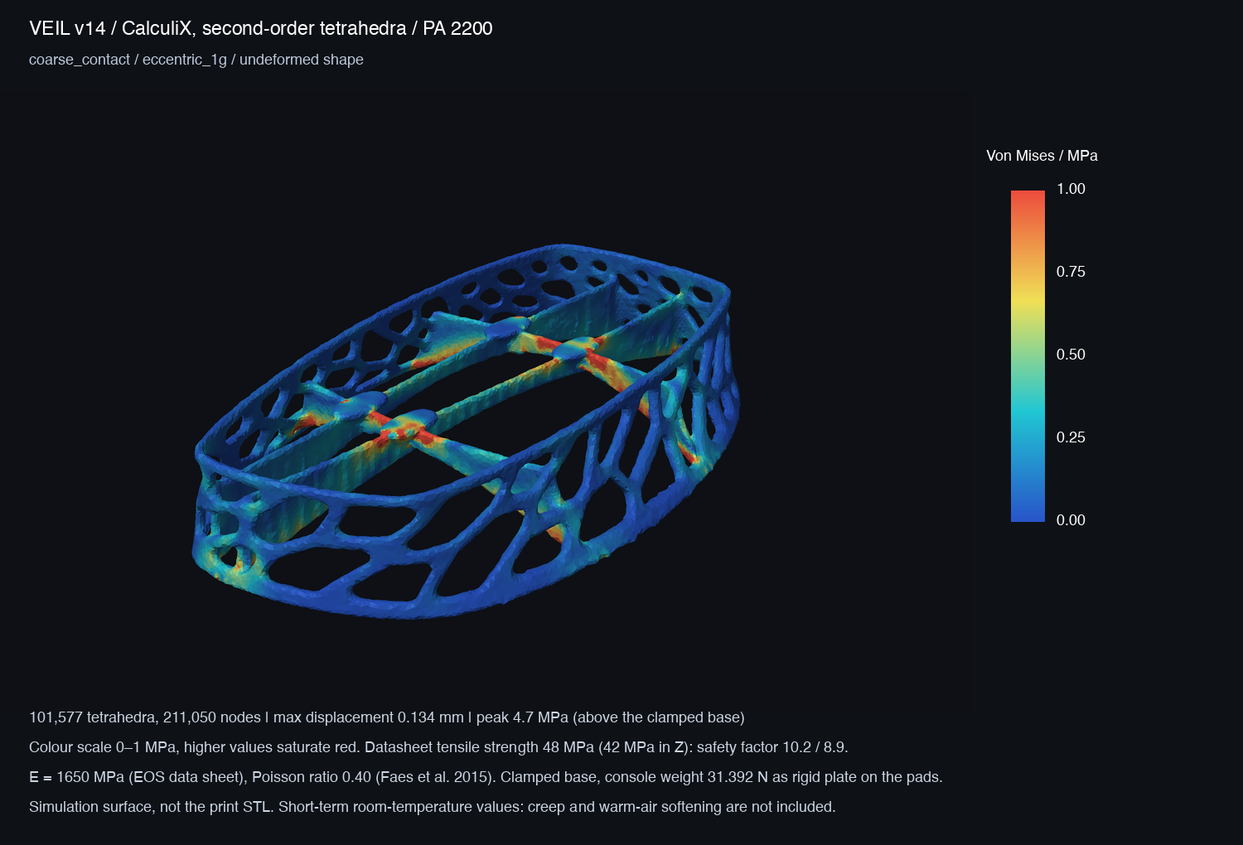
designs/v14/output/ccx_coarse_contact_eccentric_1g_stress.png
