tsonubin/ps5-slim-stand/designs/v14/output/ccx_coarse_pressure_rim_side_10N_stress.png

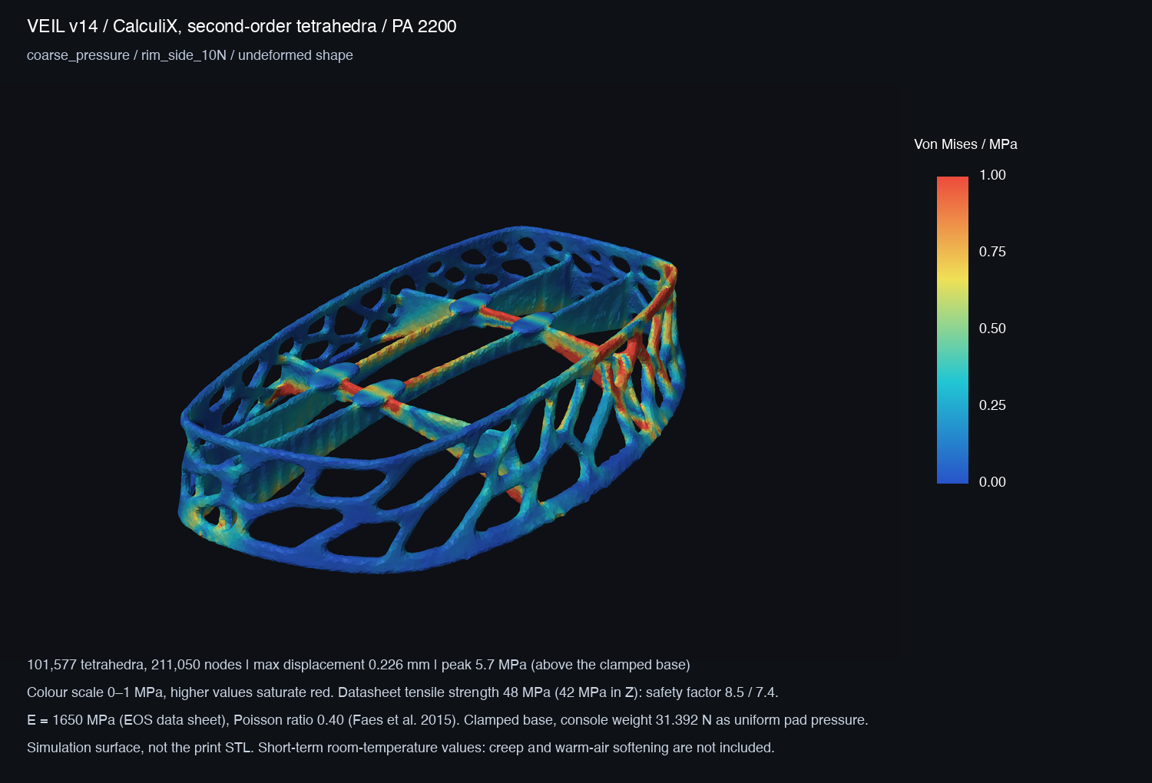
designs/v14/output/ccx_coarse_pressure_rim_side_10N_stress.png
