tsonubin/ps5-slim-stand/designs/v14/output/ccx_fine_contact_rim_side_10N_stress.png

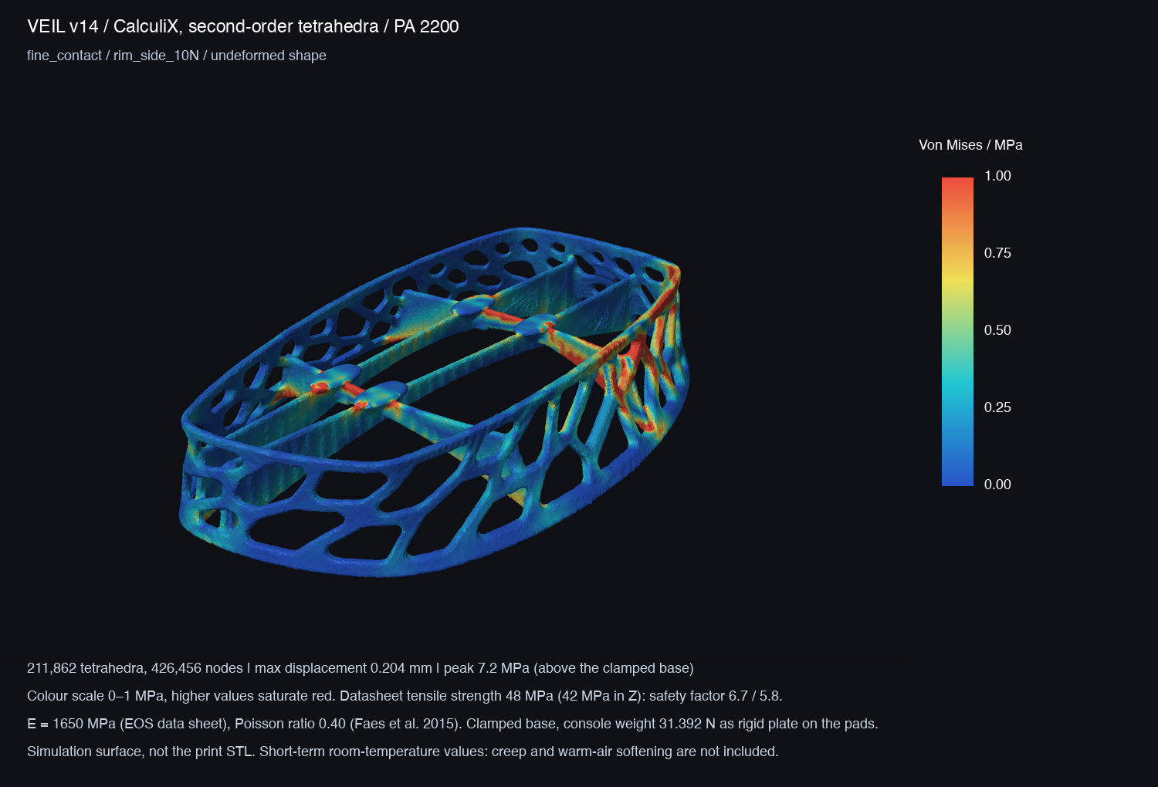
designs/v14/output/ccx_fine_contact_rim_side_10N_stress.png
