tsonubin/ps5-slim-stand/designs/v14/output/ccx_fine_contact_vertical_1g_stress.png

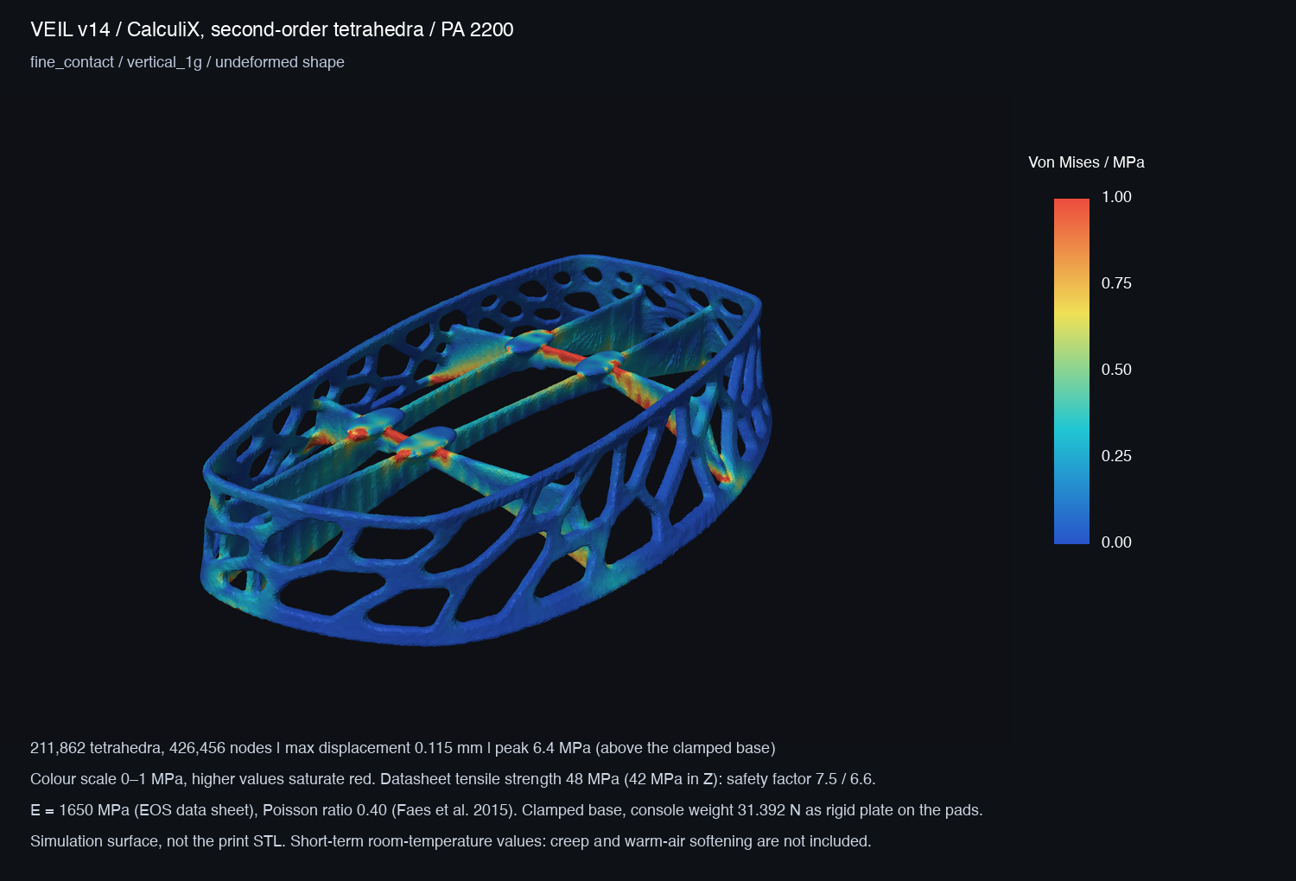
designs/v14/output/ccx_fine_contact_vertical_1g_stress.png
