tsonubin/ps5-slim-stand/designs/v14/output/hero_v14.png

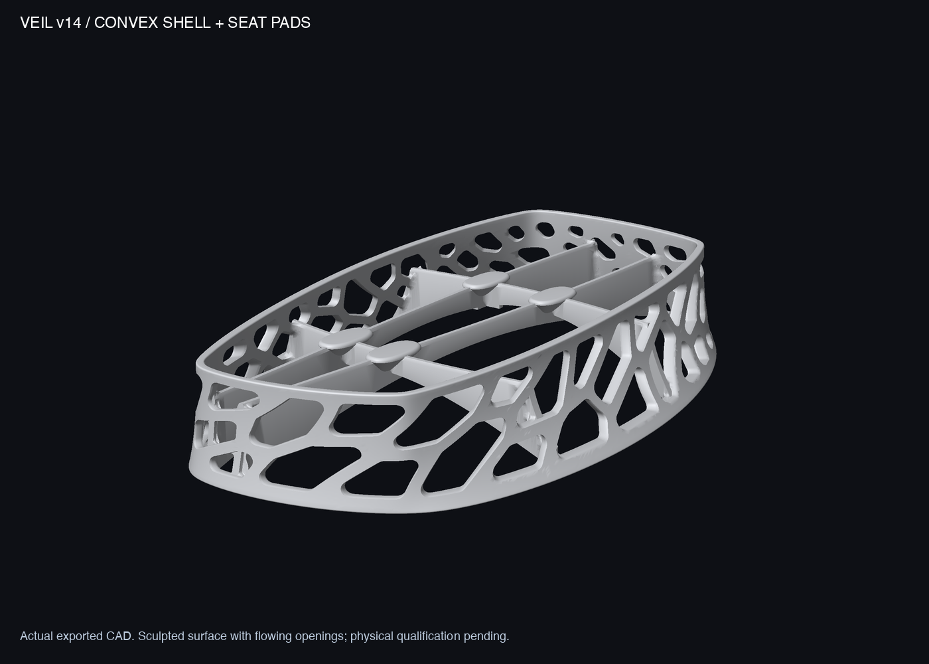
designs/v14/output/hero_v14.png
