tsonubin/ps5-slim-stand/designs/v14/output/preview_v14_clean.png

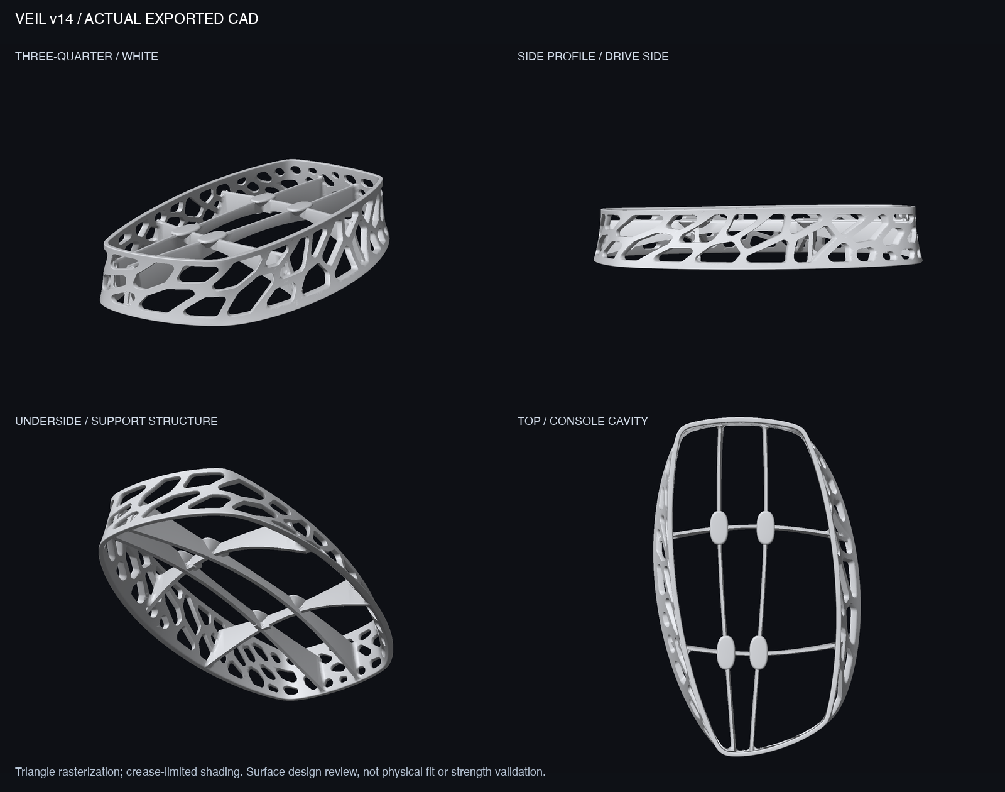
designs/v14/output/preview_v14_clean.png
