tsonubin/ps5-slim-stand/designs/v14/output/rib_foot_fillets_before_after.png

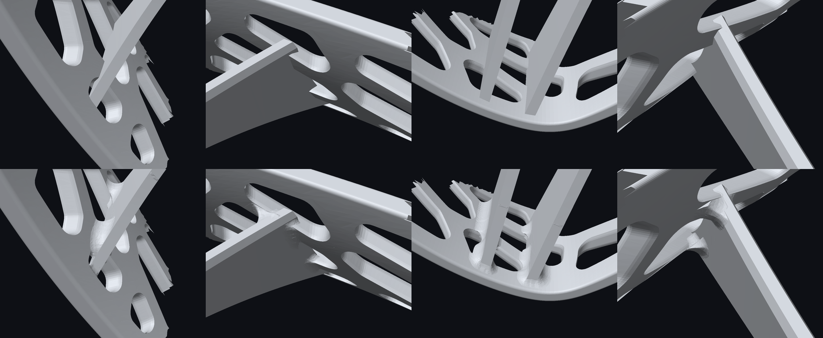
designs/v14/output/rib_foot_fillets_before_after.png
