tsonubin/ps5-slim-stand/designs/v14/output/side_profile_flat.png

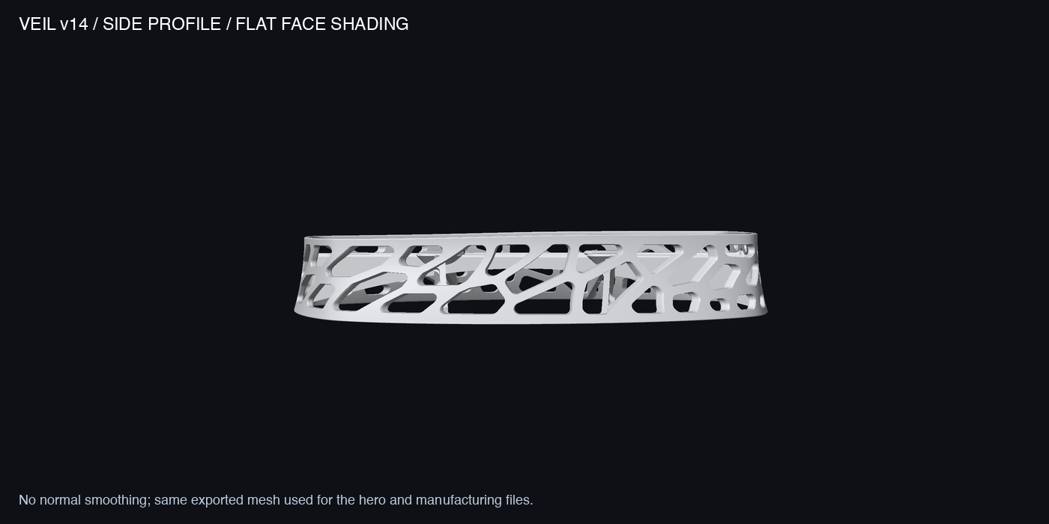
designs/v14/output/side_profile_flat.png
