tsonubin/ps5-slim-stand/designs/v14/output/turntable_v13.png

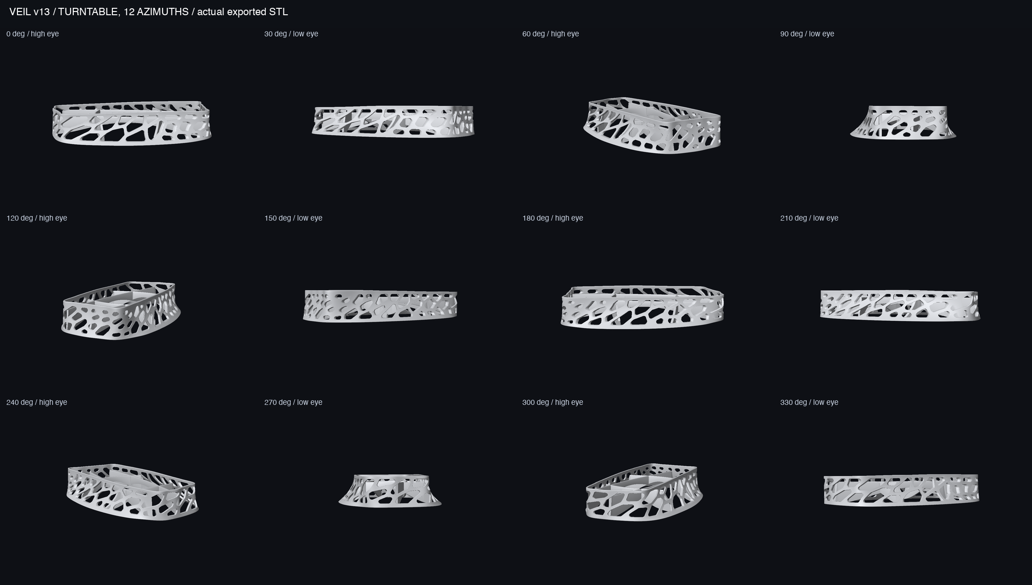
designs/v14/output/turntable_v13.png
