tsonubin/ps5-slim-stand/references/user-imports/preview.png

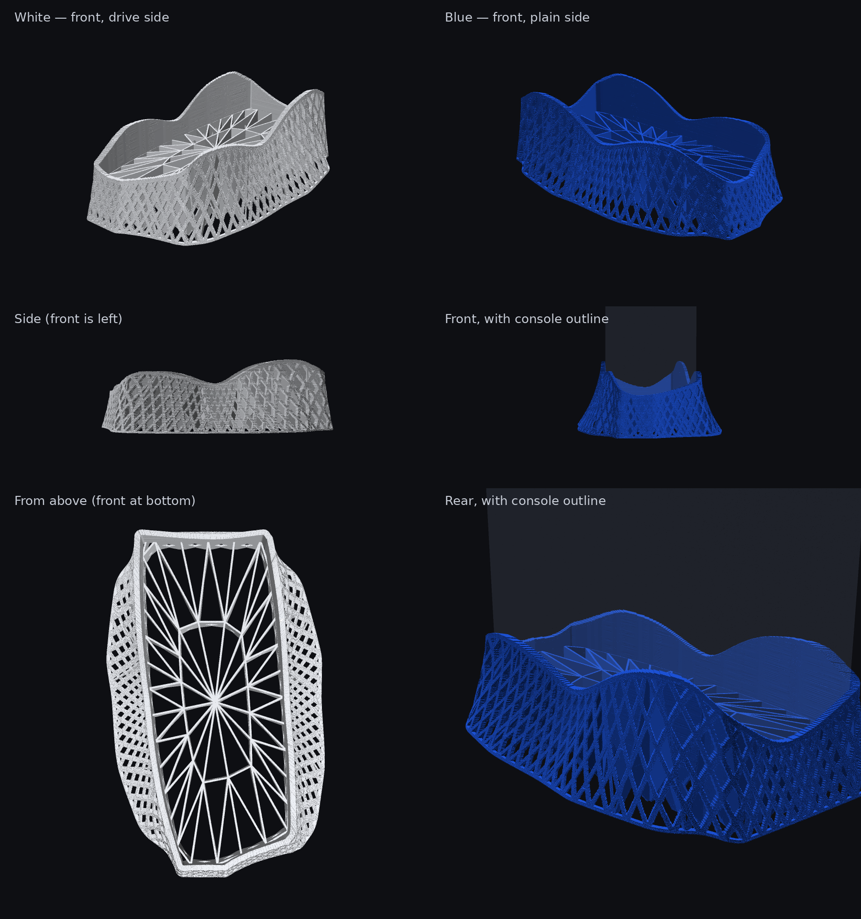
references/user-imports/preview.png
