tsonubin/ps5-slim-stand/designs/v14/baseline_v13/veil_v13_prototype.stl

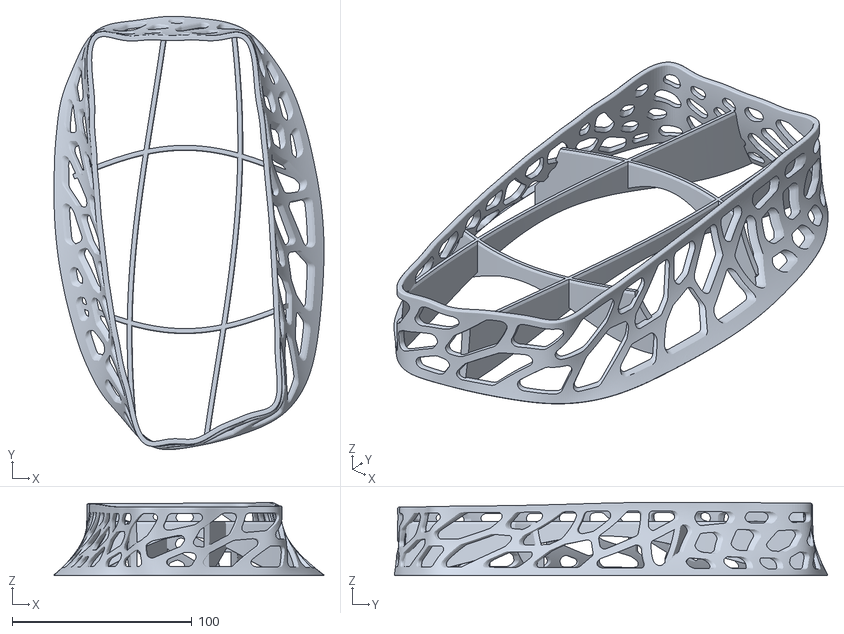
[picture p18: CAD file, 2026-11-12]
designs/v14/baseline_v13/veil_v13_prototype.stl
150.3 x 241.3 x 40.7
