tsonubin/ps5-slim-stand/designs/v14/output/veil_v14_prototype.3mf

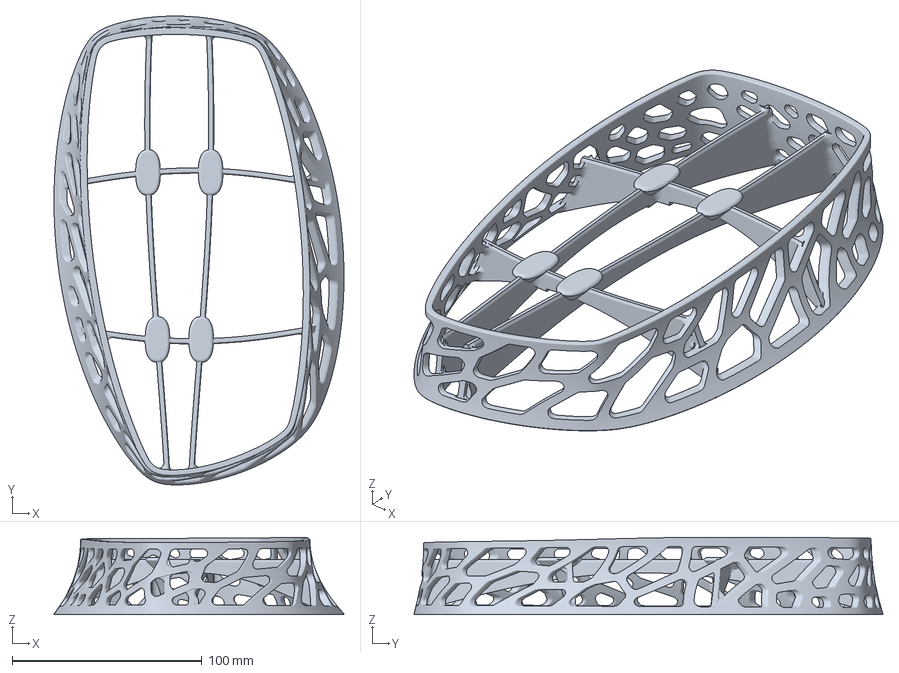
[picture p19: CAD file, 2026-11-12]
designs/v14/output/veil_v14_prototype.3mf
152.8 x 247.1 x 40.7 mm
