tsonubin/ps5-slim-stand/references/user-imports/ps5_slim_disc_veil_stand.3mf

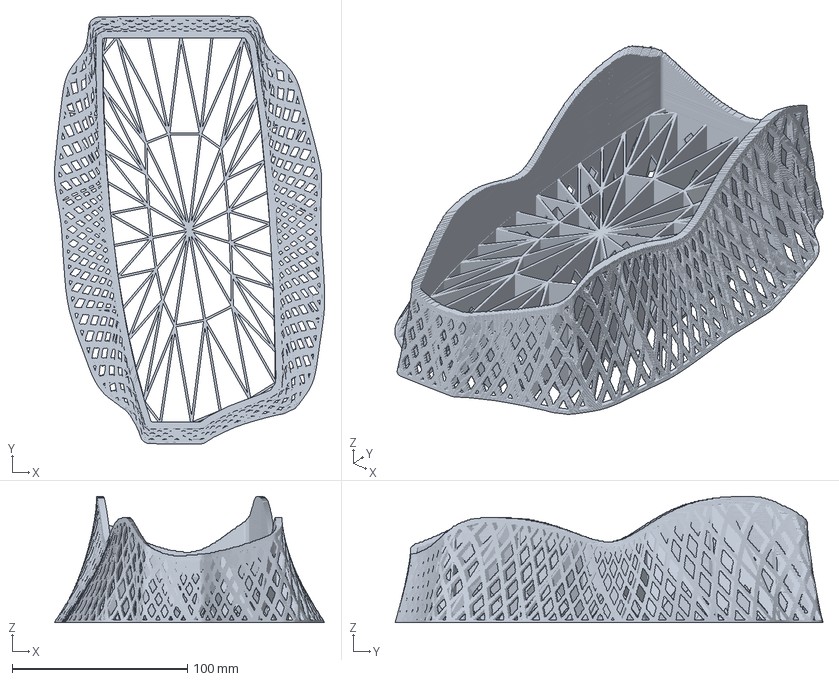
[picture p20: CAD file, 2026-11-11]
references/user-imports/ps5_slim_disc_veil_stand.3mf
154.1 x 244.0 x 72.0 mm
