tsonubin/ps5-slim-stand/designs/v14/baseline_v13/GAUGE_v13_cavity_1.6mm.stl

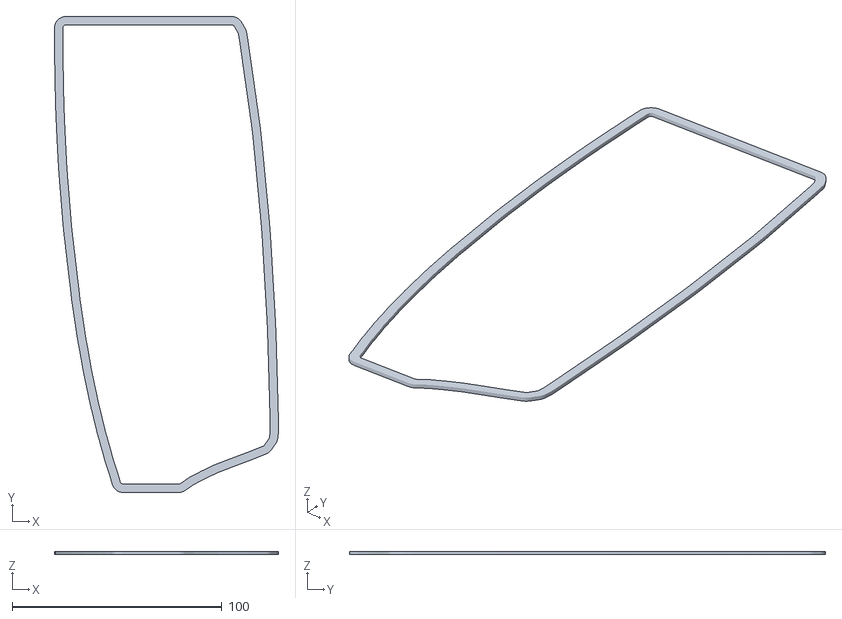
[picture p21: CAD file, 2026-11-12]
designs/v14/baseline_v13/GAUGE_v13_cavity_1.6mm.stl
106.9 x 227.0 x 1.60
