tsonubin/ps5-slim-stand/designs/v14/output/PRINT_TEST_v14_section.stl

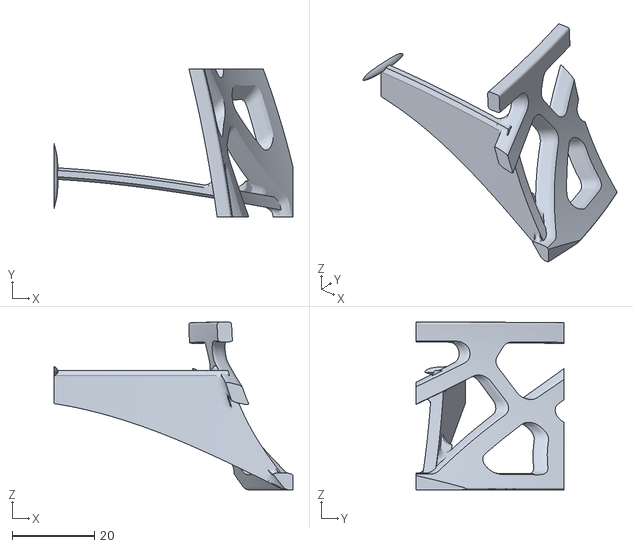
[picture p22: CAD file, 2026-11-12]
designs/v14/output/PRINT_TEST_v14_section.stl
58.0 x 36.0 x 40.7
