tsonubin/ps5-slim-stand/(list of files, cad)

Other CAD files:
designs/v14/analysis/regularized.stl
designs/v14/ccx/surf_coarse.stl
designs/v14/ccx/surf_xfine.stl
designs/v14/ccx/surf_fine.stl
designs/v14/output/veil_v14_prototype.stl
