tsonubin/ps5-slim-stand/designs/v14/output/reference_assembly_clean.png

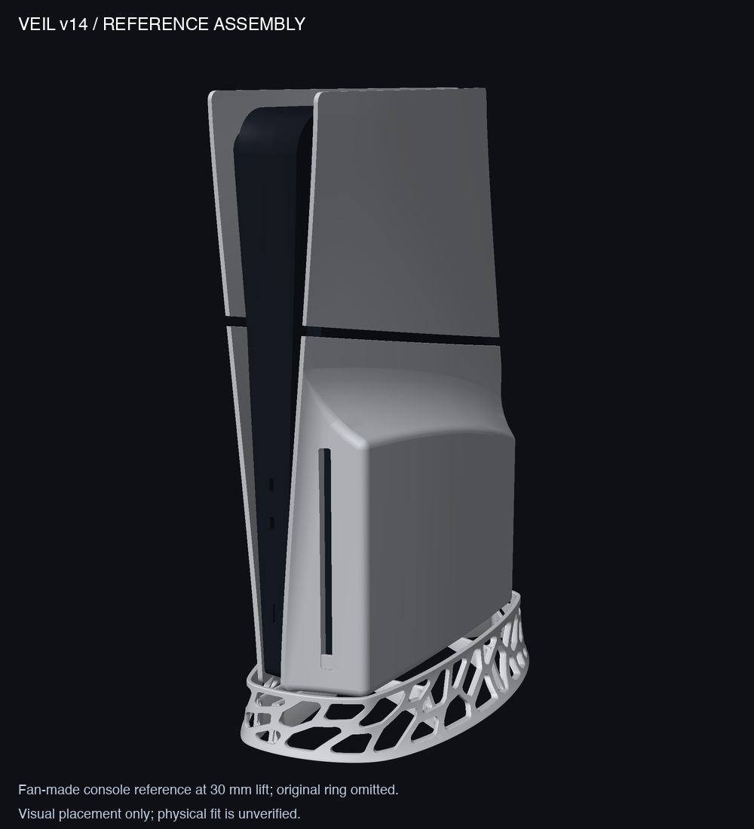
designs/v14/output/reference_assembly_clean.png
