tsonubin/ps5-slim-stand/(commit log)

2026-11-11 Preserve imported PS5 Slim stand sources and v6 baseline
    [GAUGE_cavity_outline_1.6mm.stl, GAUGE_v6_cavity_1.6mm.stl, PRINT_TEST_v6_section.stl, ps5_slim_disc_veil_stand.3mf, ps5_slim_disc_veil_stand.stl, veil_v6_prototype.3mf, veil_v6_prototype.stl]
2026-11-11 Add dense flowing v10 nest design and preserve structural study
    [GAUGE_v10_cavity_1.6mm.stl, GAUGE_v7_cavity_1.6mm.stl, GAUGE_v8_cavity_1.6mm.stl, GAUGE_v9_cavity_1.6mm.stl, PRINT_TEST_v10_section.stl, PRINT_TEST_v7_section.stl, PRINT_TEST_v8_section.stl, PRINT_TEST_v9_section.stl]
2026-11-11 Smooth v11 guide curves and blend ring and web connections
    [GAUGE_v11_cavity_1.6mm.stl, PRINT_TEST_v11_section.stl, undercroft_sleek.stl, veil_v11_prototype.3mf]
2026-11-11 Replace tube basket with sculpted v12 shell and flowing openings
    [GAUGE_v12_cavity_1.6mm.stl, PRINT_TEST_v12_section.stl, veil_v12_prototype.3mf, veil_v12_prototype.stl]
2026-11-11 Smooth perimeter loops and add v13 stress and airflow investigations
    [GAUGE_v13_cavity_1.6mm.stl, PRINT_TEST_v13_section.stl, veil_v13_prototype.3mf, veil_v13_prototype.stl]
2026-11-12 Add v14: convex wall, seat pads, stiffer long sides, open-arch ribs
    Rebuild the exterior as a strictly convex surface, rest the console on
    four flat pads, thicken the wall inward along the long sides and widen
    the rib arches. Add wall, seat, stress and airflow reviews, a
    table-sealed wall-intake airflow case, and a Gmsh + CalculiX stress
    study with EOS PA 2200 properties cross-checked against scikit-fem.
    OpenFOAM case files and Docker compose setup are included but the
    OpenFOAM sweep has not been run; designs/v14/HANDOFF.md lists what is
    finished and what is pending.
    [GAUGE_v14_cavity_1.6mm.stl, PRINT_TEST_v14_section.stl, veil_v14_prototype.3mf, veil_v14_prototype.stl]
2026-11-12 Track v14 meshes and compact solver results with Git LFS
    [regularized.stl, surf_coarse.stl, surf_fine.stl, surf_xfine.stl]
2026-11-12 Blend v14 rib feet, finish CalculiX contact and OpenFOAM studies, add print brief
    - Rib ends are blended into the wall (3 mm rolling-ball fillet, 1.5 mm inside the
    wall thickness). The governing stress peak was a rib end touching the rim of a
    wall opening at one point; the weight-case peak now holds at 4.6-4.9 MPa on
    three meshes (was 11-15 MPa and rising). 79.26 cm3.
    - All reviews, in-house screens and Gmsh/CalculiX cases rerun on the final
    geometry; fine-mesh rigid-plate contact and per-pad contact forces added.
    - OpenFOAM: case generator now writes final fields; flow sweep with and without
    the stand, mesh checks, comparison with the lattice-Boltzmann screen.
    - Print brief (Engli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
    [PRINT_TEST_v14_section.stl, regularized.stl, surf_coarse.stl, surf_fine.stl, surf_xfine.stl, veil_v14_prototype.3mf, veil_v14_prototype.stl]
2026-11-12 Keep only v14 in the tree and rewrite the README around it
    - Remove the v5-v13 design folders (still available at their tags). The few v13
    files that v14's review scripts compare against move to designs/v14/baseline_v13.
    - Top-level README: specifications, design philosophy, stress test, airflow test,
    printing notes, open items.
    [GAUGE_cavity_outline_1.6mm.stl, GAUGE_v11_cavity_1.6mm.stl, GAUGE_v12_cavity_1.6mm.stl, GAUGE_v13_cavity_1.6mm.stl, GAUGE_v6_cavity_1.6mm.stl, GAUGE_v7_cavity_1.6mm.stl, GAUGE_v8_cavity_1.6mm.stl, GAUGE_v9_cavity_1.6mm.stl]
